University-Academics/MPPT-CHARGE-CONTROLLER/README.md

# MPPT-CHARGE-CONTROLLER
EN2110 : Project
