University-Academics/MPPT-CHARGE-CONTROLLER/Submission Files/MPPT.pptx

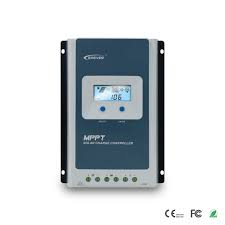
[picture p7: figure]

MPPT
CHARGE
CONTROLLER

GROUP-13

## Slide 2

Role of a Charge Controller?

- Ensure Safety of Battery
  - Over Charging
  - Deep Discharging
  - Proper charging parameters
- Ensure safety of Solar Panels
  - Dusk/ night : Back flow protection
- Effective power management

Direct Connection
PWM Charge Controller
MPPT

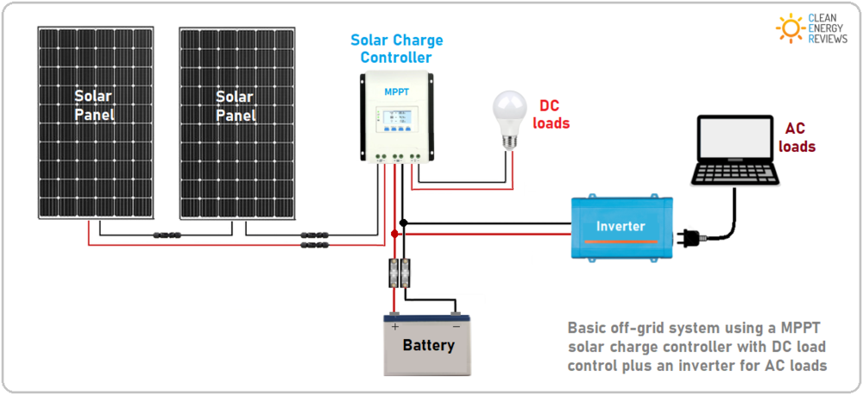
[picture p8: figure]

## WHY MPPT?

But due to environmental fluctuations

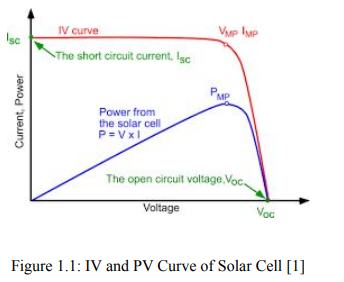
[picture p9: figure]

MPPT Algorithm must constantly tracking the Maximum power point. It increases the efficiency by 30%

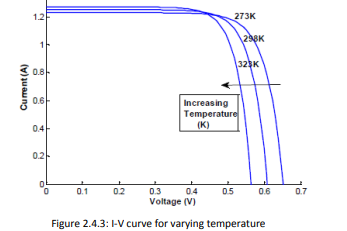
[picture p10: figure]
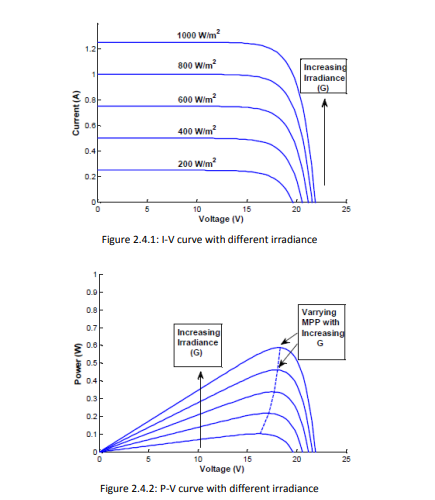
[picture p11: figure]

## IMPLEMENTATION OF MPPT

- Several methods exists.
  - Perturb and Observe method
  - Incremental conductance method
  - Constant voltage method

Perturb and Observe method(Our Project uses this method)
- Easy to implement
- constantly checking the voltage (or current in some systems) and continuing to increase the voltage as long as the power continues to increase
- Disadvantage is the system oscillates around the power point

Incremental Conductance Method
- Implementation is complex
- Accuracy is higher than P & O method

## MPPT ALGORITHM(P & O Method)

- •Simplest method of MPPT
- •Hill climbing method on two-point power comparison method
Concept

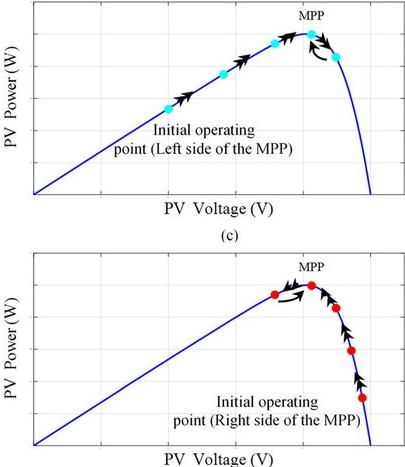
[picture p12: figure]
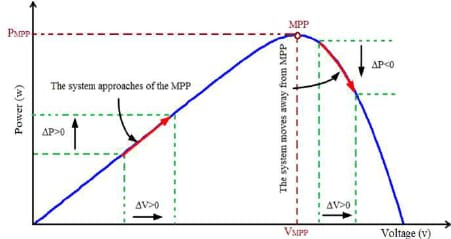
[picture p13: figure]

## Flow Chart

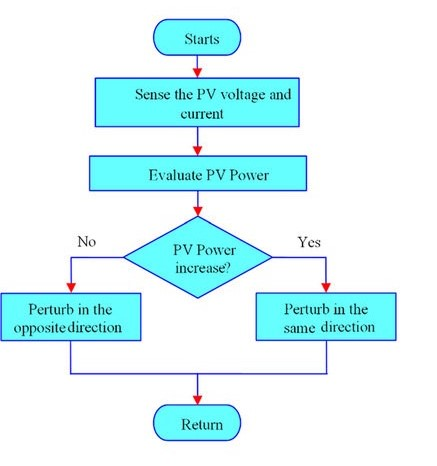
[picture p14: figure]
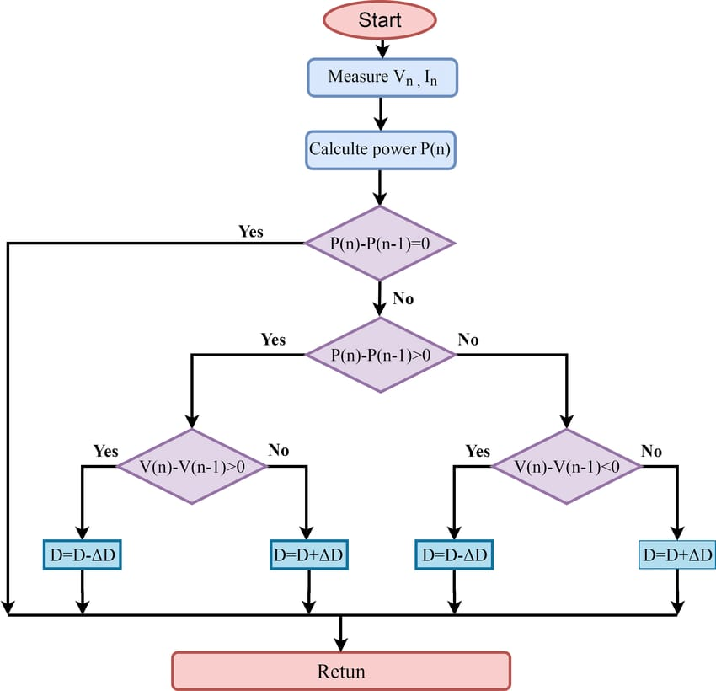
[picture p15: figure]

## Functional Block Diagram

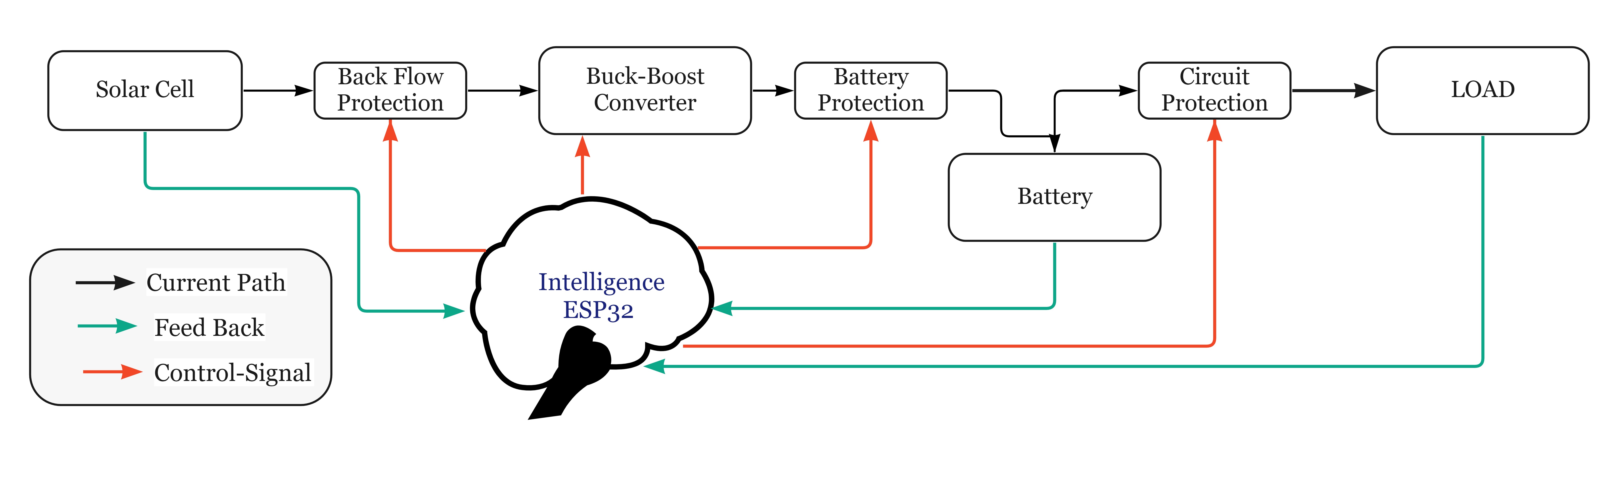
[picture p16: figure]

## Specifications

- 40V, 30A Input(Solar, Wind Turbines, PSU)
  - 12V OUTPUT/ BATTERY - 420W @35A
  - 24V OUTPUT/ BATTERY - 840W @35A
- Wi-Fi & Bluetooth
- 98% Peak conversion efficiency
- Battery & Input Disconnect Recovery Protocol
- Settable PWM Switching Frequency(1.2kHz - 312kHz)

## What to Expect ??

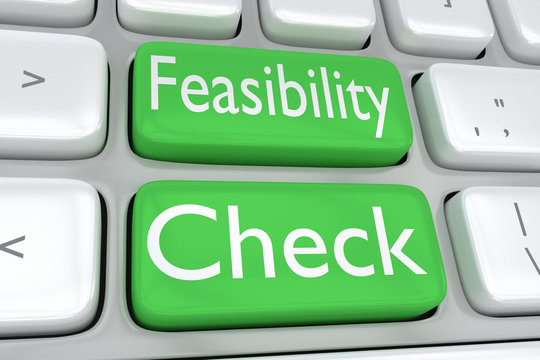
[picture p17: figure]

- 30V,10A Input(Solar)
  - 12V OUTPUT/BATTERY - 60W@5A
- 90 % Peak-Conversion Efficiency
- Settable PWM Frequency
- Two 12V Smart lighting system as Load (20W)

## Buck Converter

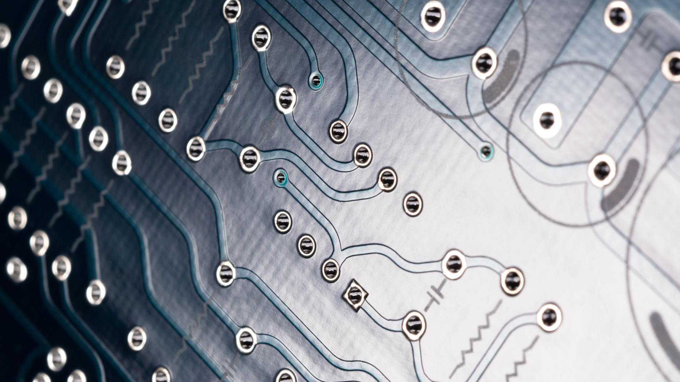
[picture p18: figure]
An electronic circuit board in blue colour

## Asynchronous Buck Converter

- Typical Efficiency: 75-87%
- Notable power loss across the diode’s forward voltage drop (V_f =0.6V−1.2V).
- Easy and straight forward implementation

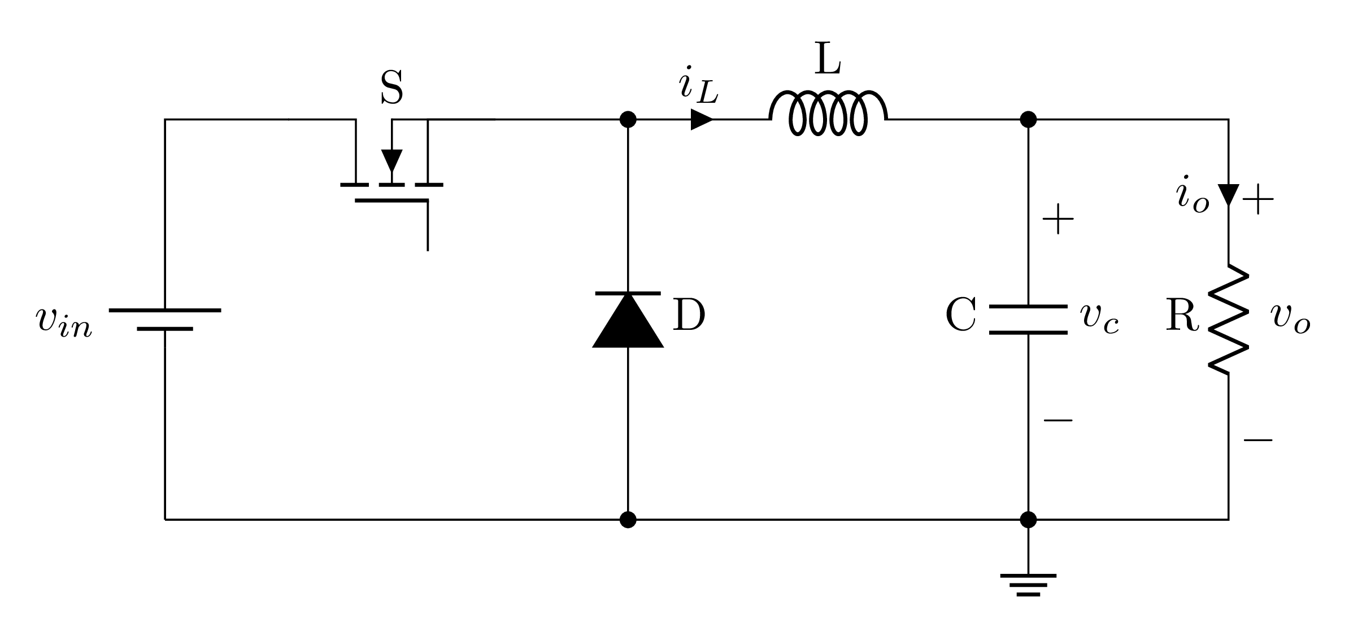
[picture p19: figure]

Solution : Synchronous Buck Converter

## Synchronous Buck Converter

- Typical Efficiency: 88-98%
- Minuscule losses formed across MOSFET’s on-resistance
- Proper implementation of switching required.

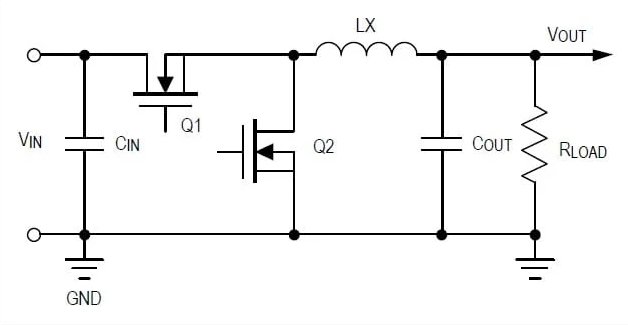
[picture p20: figure]

Solution : Use Half-Bridge MOSFET driver

## Half-Bridge MOSFET driver (IR2104)

- Fully operational to +600V.
- Gate drive supply range from 10 to 20V.
- High side output in phase with input.
- Shut down input turns off both channels

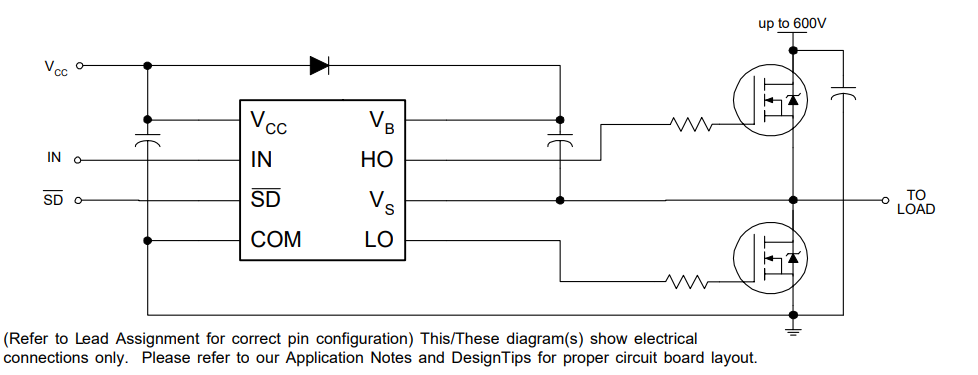
[picture p21: figure]
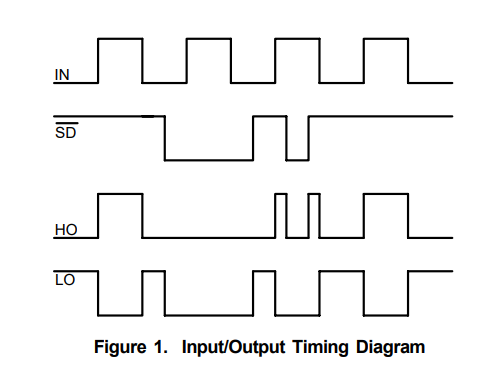
[picture p22: figure]
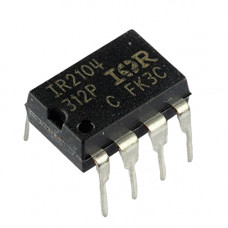
[picture p23: figure]

## MOSFET Selection

- Should be capable of high frequency switching.
- Should be capable of high drain current. I_D ≥35A.
- Should have low on-resistance.
- Low conduction loss and switching loss.

We have chosen IRFZ48N MOSFET.

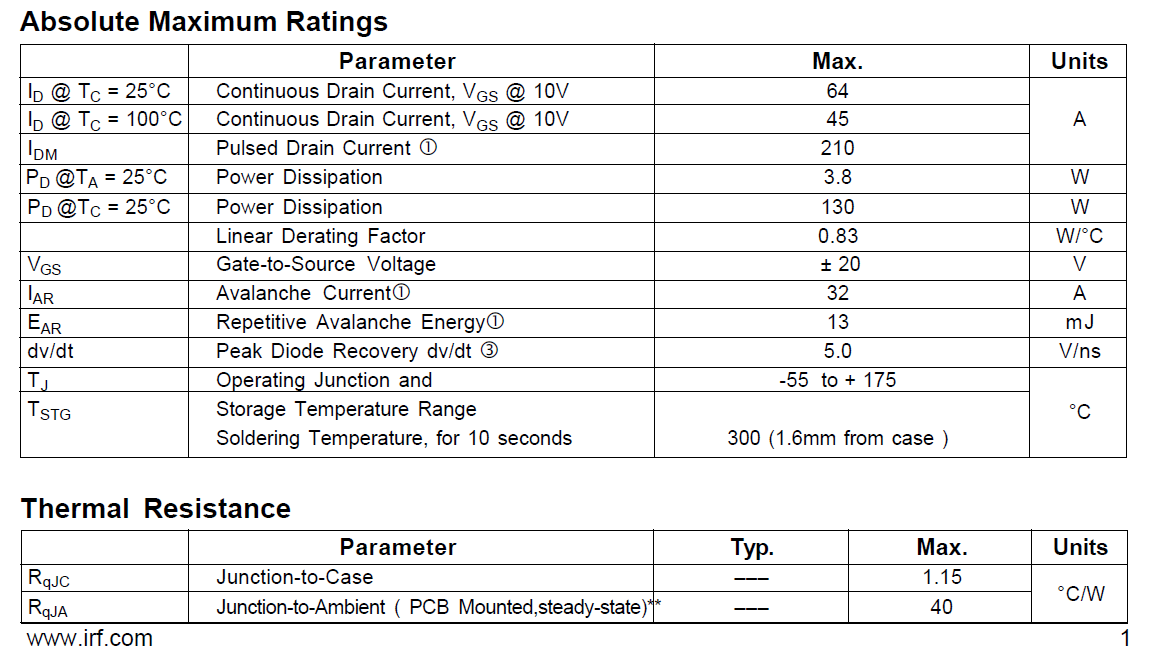
[picture p24: figure]

## Inductor Selection

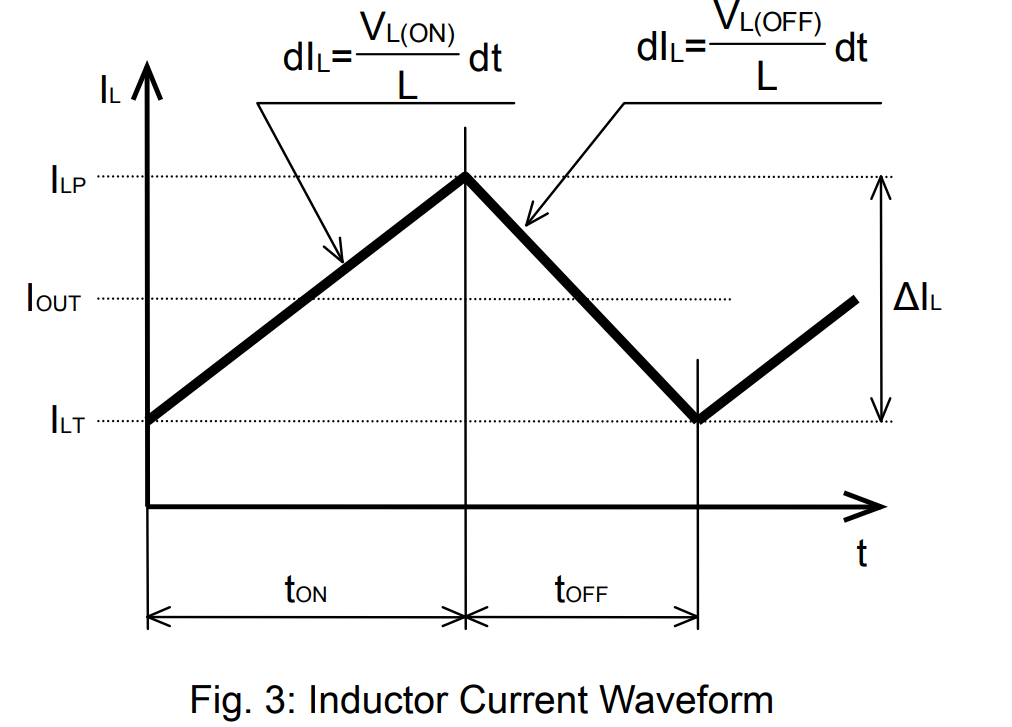
[picture p25: figure]

- We are design 840W solar panel.
- Input voltage V_(in) =40V.
- Output voltage V_(out) =24V.
- ∴I_(out) =(840W)/(24V)=35A.
- Ripple current ΔI_L is taken as 20% of I_(out) .
- PWM frequency 30kHz.
L=(V_(out) ×(V_(in) −V_(out) ))/(ΔI_L ×f_s ×V_(in))
L≈48μH

We plan to wind a toroidal inductor with L=48μH.

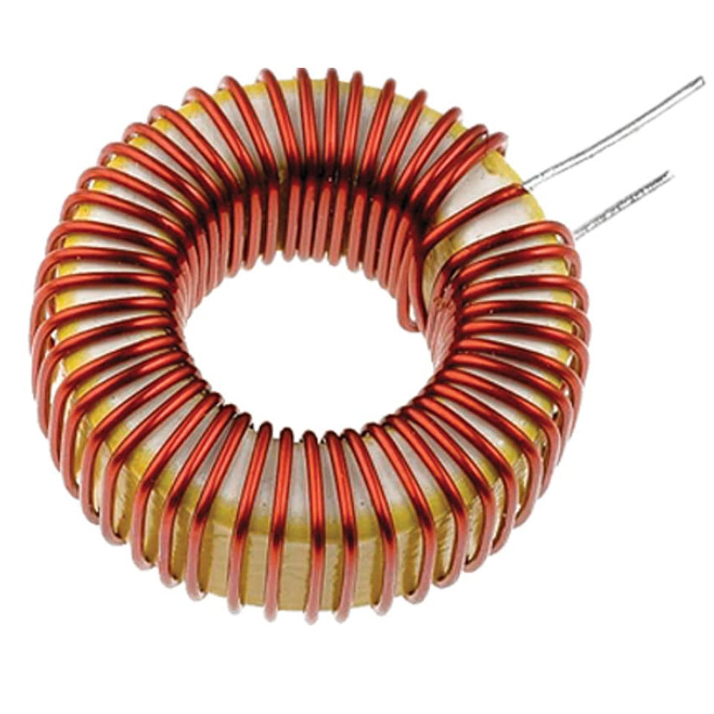
[picture p26: figure]
Custom Inductors & Chokes : The Talema Group

Reference : Texas Instruments (https://www.ti.com/lit/an/slva477b/slva477b.pdf?ts=1652065112004)

## Output Capacitor Selection

- Output capacitance is required to minimize the voltage overshoot and ripple at the output.
- Should have low equivalent-series resistance (ESR).
- Output ripple voltage is taken as 60mV.
C_(out) =(ΔI_L)/(8f_s ΔV_(out))
≈470μF

Required 470μF output capacitor.

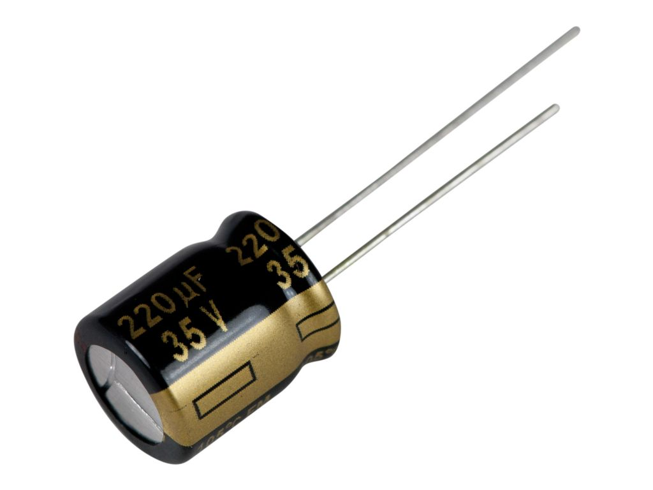
[picture p27: figure]
Radial electrolytic capacitor Low ESR CE 220u/35VIT PAN-FM 10x12,5 RM5 | GM electronic COM

Reference : Texas Instruments (https://www.ti.com/lit/an/slva477b/slva477b.pdf?ts=1652065112004)

## Slide 17

Voltage Measurement

- Two voltage divider circuits are used to measure solar panel and battery voltage.

- Two analog pins of the esp32 are used to read voltages.

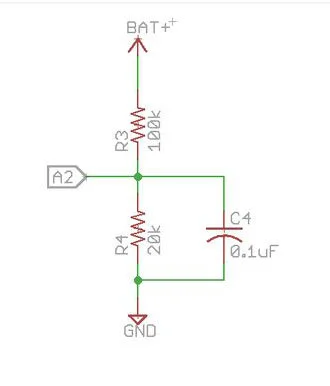
[picture p28: figure]

For the battery voltage measuring

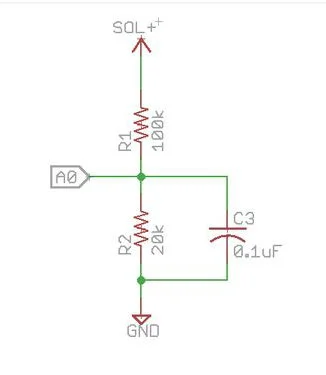
[picture p29: figure]

For the solar panel voltage measuring

Vout = R2/(R1+R2) x Vin
Vin = (R1+R2)/R2 x Vout
Solar Panel = ADC x 0.0049 x (R1+R2)/R2

Count

Voltage

## Slide 18

Current Measurement

- ASC712 (5A) current sensor is used to measure the current.

ASC712 current sensor :

- Sensitivity is 185mV/A

- The power supply is 5V

- The sensor can measure positive and negative currents (-5A to +5A)

- Offset is 2.5V

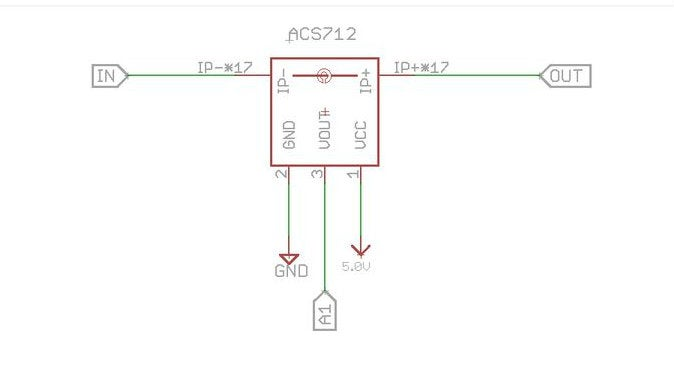
[picture p30: figure]

Value = (5/1024) x analog read value

Current in amp = (value-2.5)/0.185

## Slide 19

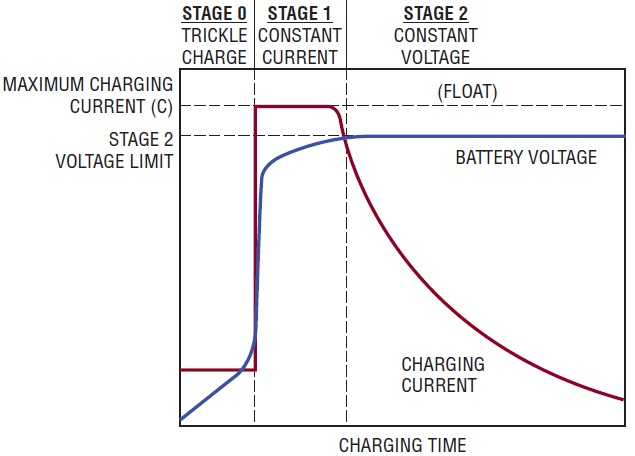
[picture p31: figure]

Battery Charging Stages

Click to add text

## DRIVING LOAD...!

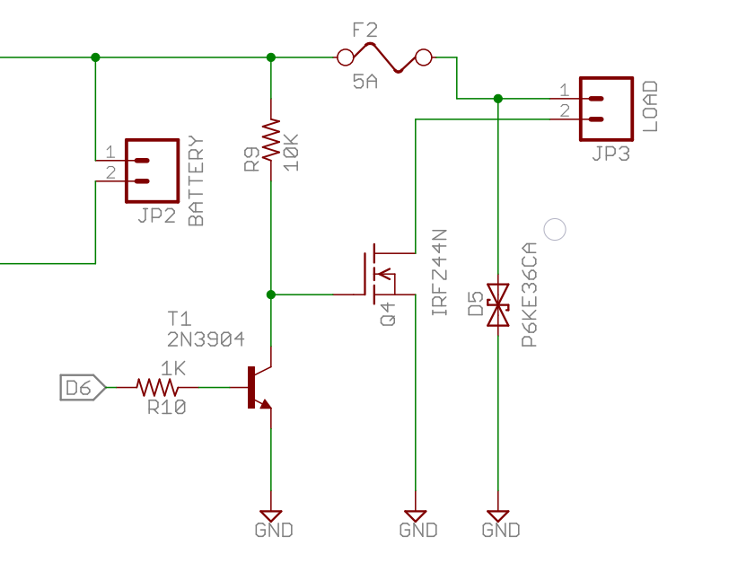
[picture p32: figure]

No Requirements for Faster Switching
Protection : Fuse and TVS Diode

## Power Supplies

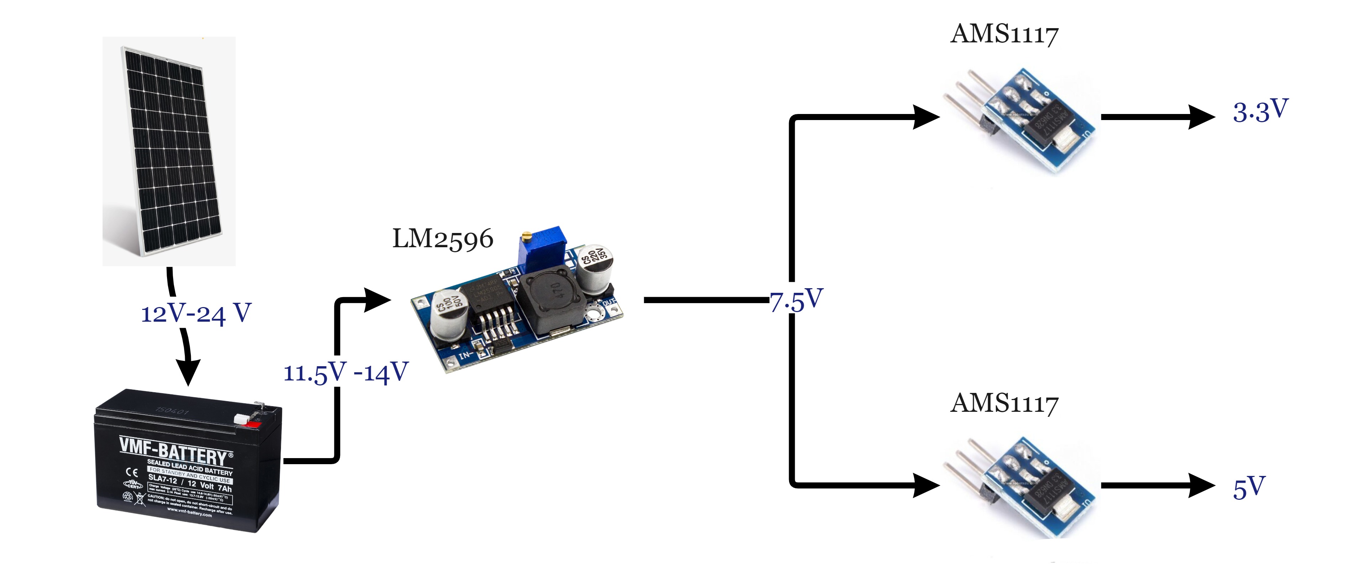
[picture p33: figure]
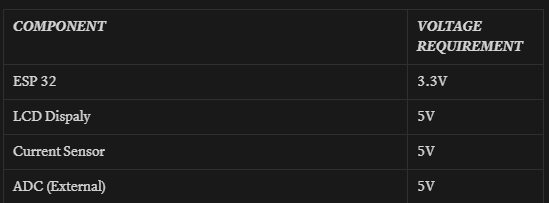
[picture p34: figure]

LINEAR REGULATOR
V_out = V_ref (1+R1/R2)
V_ref = 1.25V

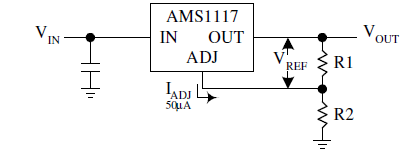
[picture p35: figure]

Dc-Dc Buck Converter

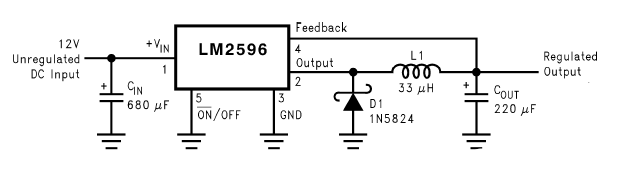
[picture p36: figure]

## Slide 22

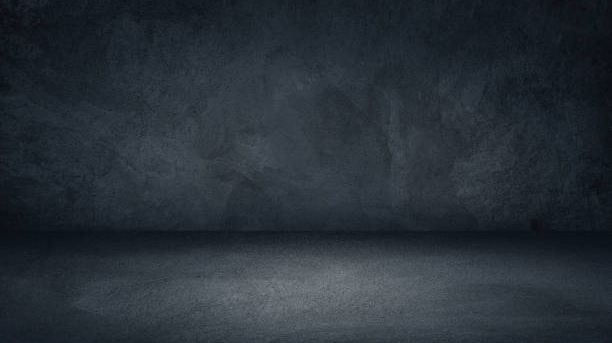
[picture p37: figure]
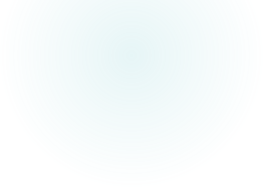
[picture p38: figure]

SAFE OPERATION....!

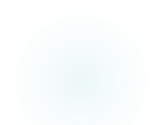
[picture p39: figure]

## Slide 23

BODY DIODE CURRENT LEAKAGE

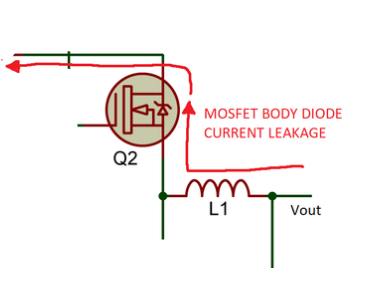
[picture p40: figure]

NEED FOR A BETTER DESIGN ?

SCHOTTKY DIODE
MOSFET & MOSFET DRIVER
ISOLATED POWER SUPPLY

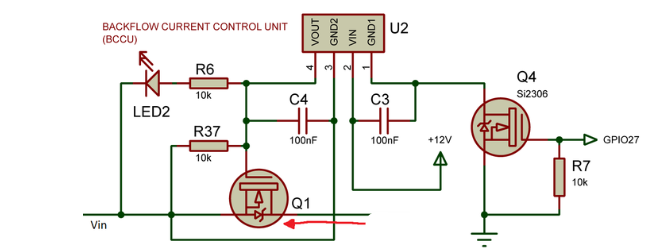
[picture p41: figure]

REVERSE BLOCKING MOSFET CONFIGURATION

## IMPLEMENTATION LEVEL

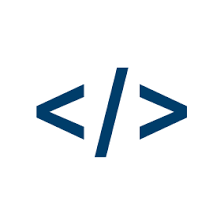
[picture p42: figure]

- LIGHTENING OVER VOLTAGE SURGE : TVS DIODE
- AUTO LOAD DISCONNECTION : DEEP DISCHRAGING
- ENSURING PROPER CHARGING PARAMETERS
  - SWITCHING TO CONSTANT VOLTAGE STAGE
  - BATTERY TEMPERATURE
- PROTECTION AGAINST FAILURES

## PLACES WHERE WE EXPECT PROBLMS

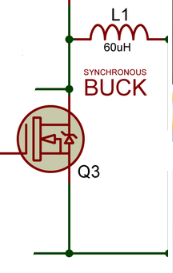
[picture p43: figure]

- DUTY CYCLE OF PWN SIGNAL : LOWER SIDE MOSFET
- NON-LINEAR RESPONSE OF ADC (ESP32)
External Precision ADC : AD1015 (12-bit resolution with 3800sps speed)
HIGHER -> Finer Voltage and Current Steps , Power Handling
- PWM FREQUENCY SELECTION :
LOWER -> Switching losses are low

ESP32 : 16 PWM PINS
16 bit resolution : 1.22kHz
12 bit resolution : 19.5kHz
11 bit resolution : 39.06kHz
10 bit resolution : 78.12kHz

## Trying to do better...!

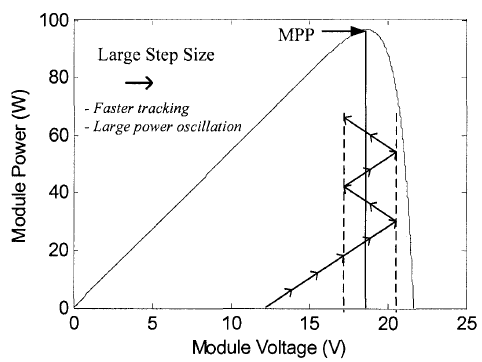
[picture p44: figure]

LARGER STEP :
OSCILLATION

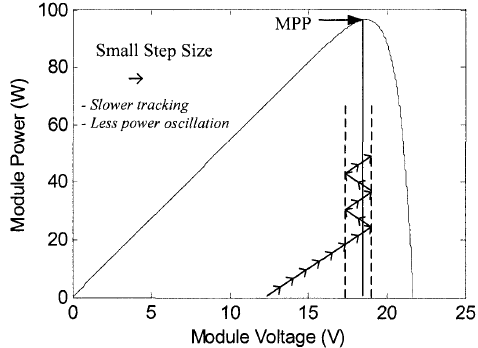
[picture p45: figure]

SMALLER STEP :
FASTER CHANGING CONDITIONS

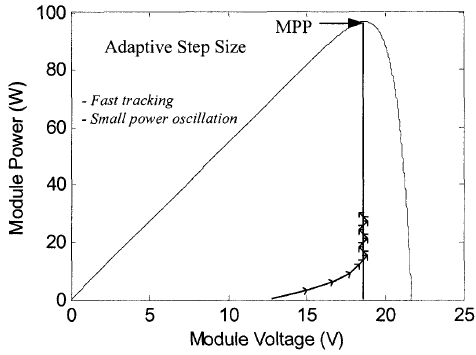
[picture p46: figure]

ADAPTIVE STEP SIZE

## Slide 27

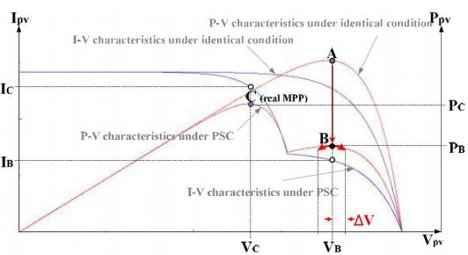
[picture p47: figure]

PARTIAL SHADING

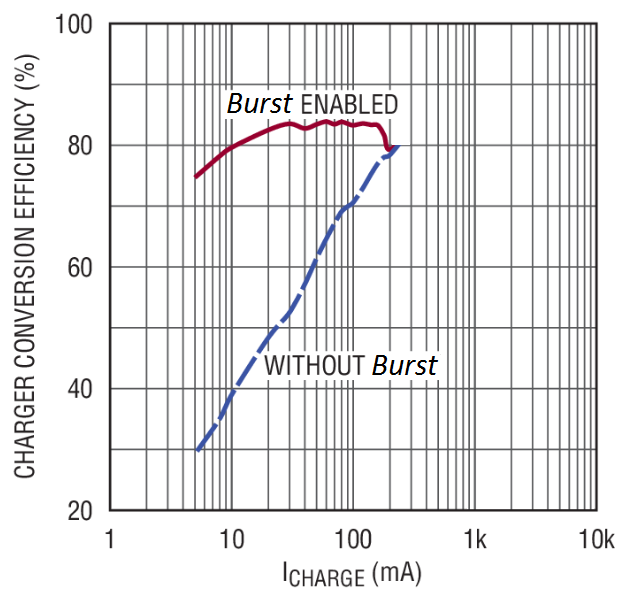
[picture p48: figure]

BURST CHARGING

SOLUTION : 5-STATE MODEL

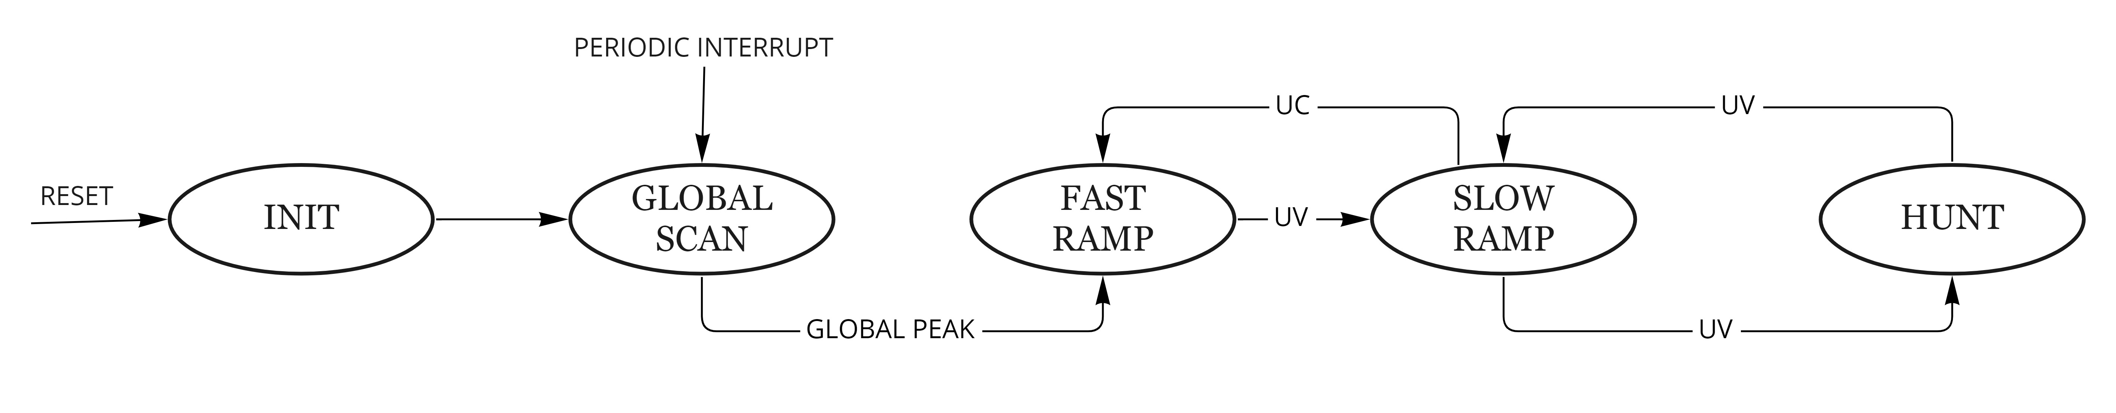
[picture p49: figure]

## EXCITED TO EXPERIMENT...!
