University-Academics/MPPT-CHARGE-CONTROLLER/References/Circuit References/second.png

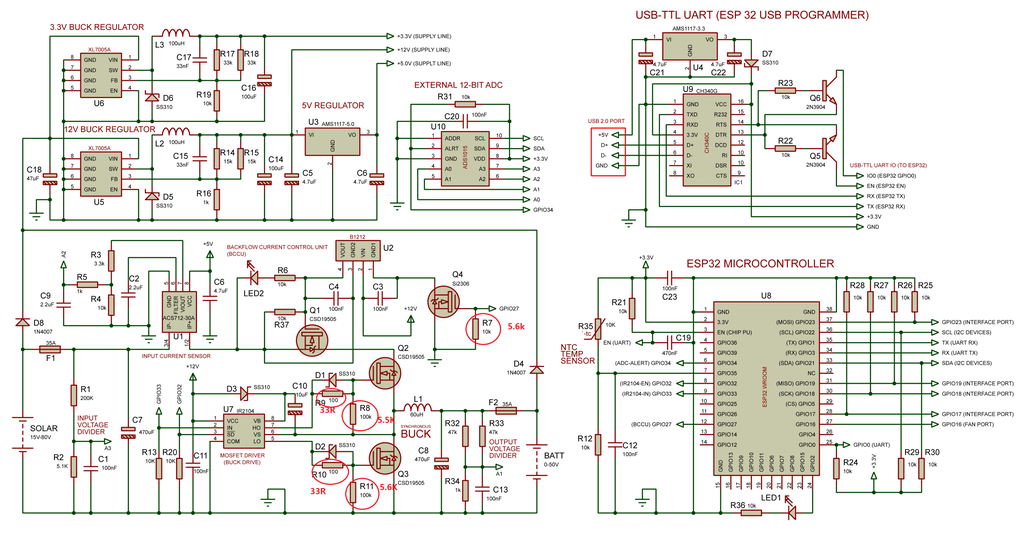
References/Circuit References/second.png
