University-Academics/MPPT-CHARGE-CONTROLLER/MPPT_PCB/schematic.pdf

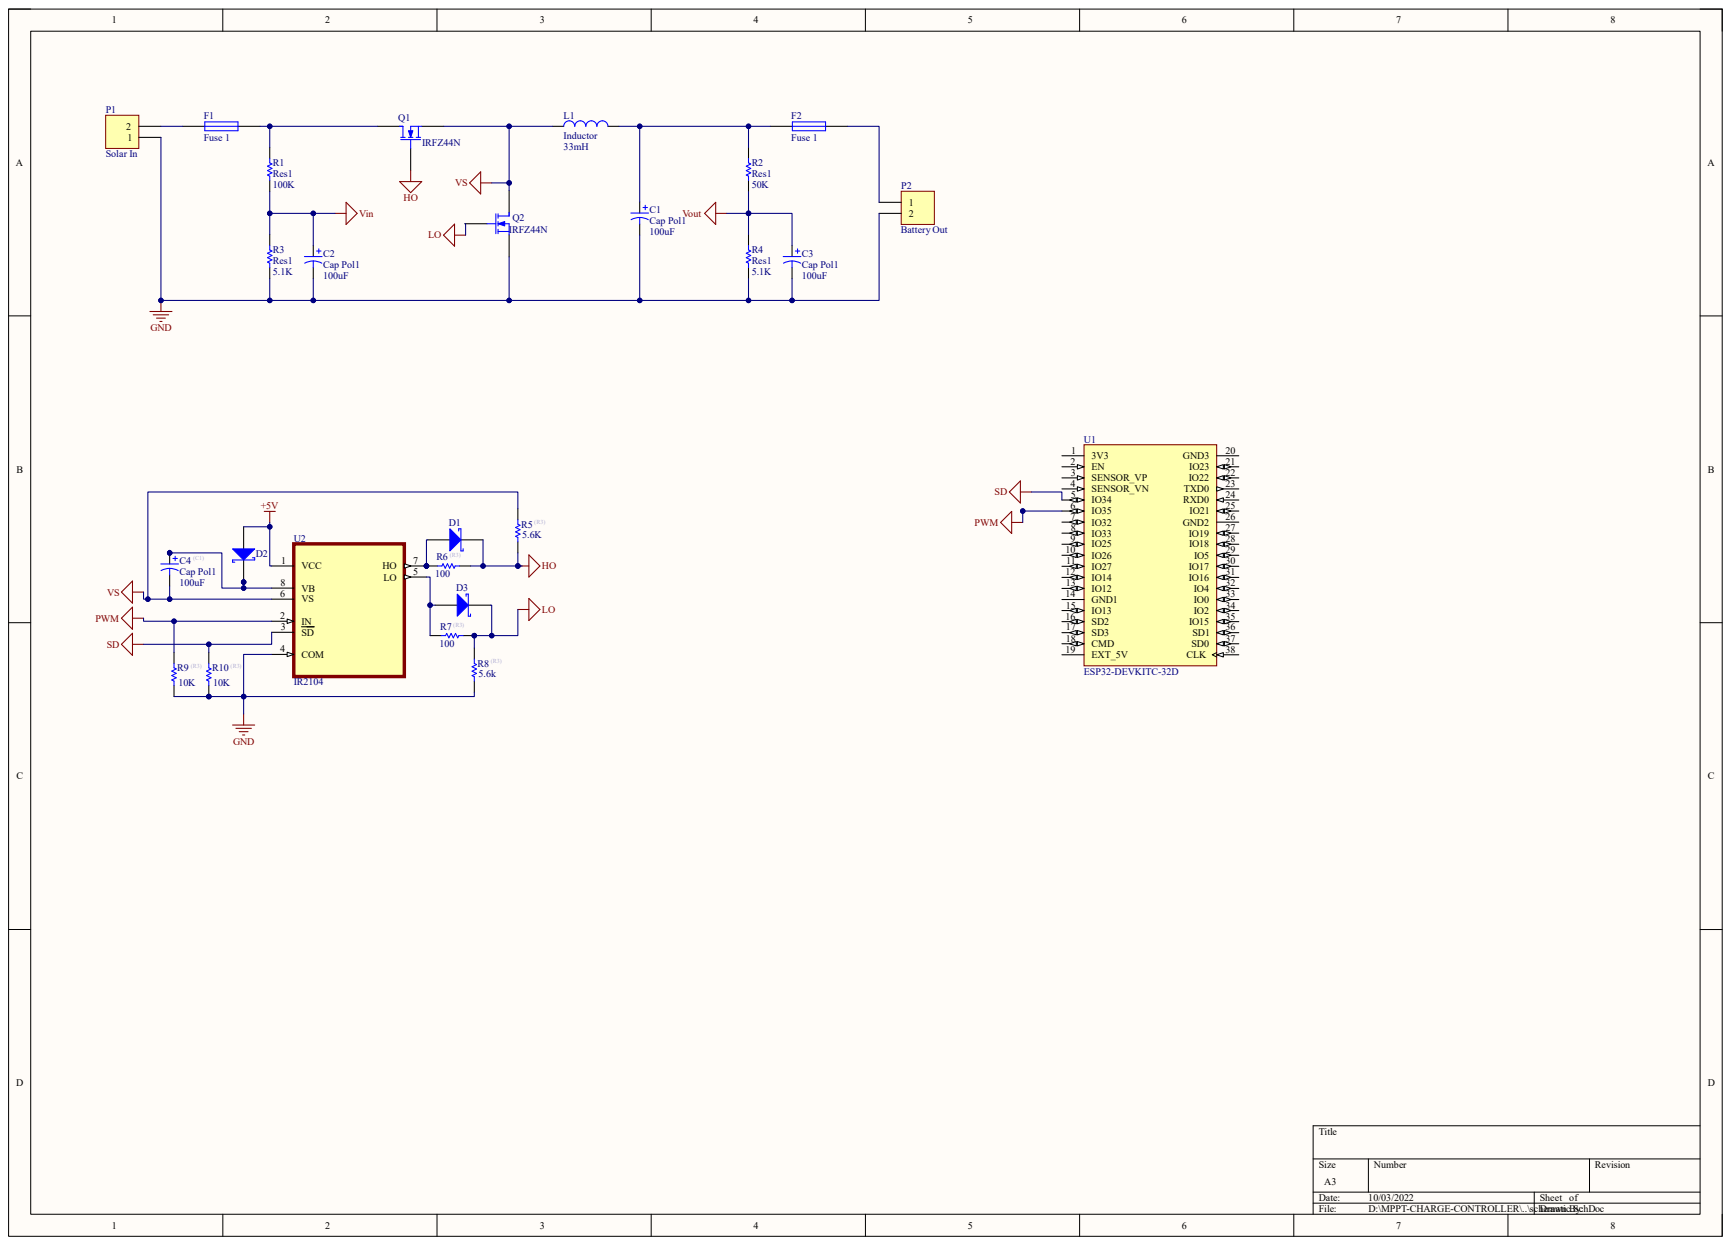
[picture p51: page 1]
