University-Academics/MPPT-CHARGE-CONTROLLER/(list of files, drawings)

Other design files:
MPPT_PCB/MPPT_PCB.PrjPcb
MPPT_PCB/schematic.SchDoc
Stimulation/Buck Converter/buck.pdsprj
