University-Academics/MPPT-CHARGE-CONTROLLER/Wifi/sketch_oct5a/sketch_oct5a.ino

#include <WiFi.h>
#include <PubSubClient.h>

const char* ssid = "DT4G";
const char* password = "iuytrewq";
const char* mqtt_server = "13.76.34.183";

WiFiClient espClient;
PubSubClient client(espClient);

void initWiFi() {
  WiFi.mode(WIFI_STA);
  WiFi.begin(ssid, password);
  Serial.print("Connecting to WiFi ..");
  while (WiFi.status() != WL_CONNECTED) {
    Serial.print('.');
    delay(1000);
  }
  Serial.println(WiFi.localIP());
}

void reconnect() {
  // Loop until we're reconnected
  while (!client.connected()) {
    Serial.print("Attempting MQTT connection...");
    // Attempt to connect
    if (client.connect("ESP8266Client", "mppt-solar", "sem4electronics@entc19")) {
      Serial.println("connected");
      // Subscribe
      //client.subscribe("esp32/output");
    } else {
      Serial.print("failed, rc=");
      Serial.print(client.state());
      Serial.println(" try again in 5 seconds");
      // Wait 5 seconds before retrying
      delay(5000);
    }
  }
}

void setup() {
  // put your setup code here, to run once:
  Serial.begin(115200);
  initWiFi();
  Serial.print("RRSI: ");
  Serial.println(WiFi.RSSI());
  client.setServer(mqtt_server, 1883);
}

void loop() {
  // put your main code here, to run repeatedly:
  if (!client.connected()) {
    reconnect();
  }
  client.loop();
  client.publish("testtopic", "tempString");
  delay(5000);
}
