University-Academics/MPPT-CHARGE-CONTROLLER/(commit log)

2022-05-09 buck converter simulation.
2022-05-09 buck converter
    [buck.pdsprj]
2022-05-09 buck converter tested.
    [buck.pdsprj]
2022-10-06 FINISHED INTIAL SKETCH IN CODING
    [buck.pdsprj]
2022-10-07 Created PCB and add some datasheets
    [MPPT_PCB.PrjPcb, PCB_Project.PrjPcb, buck.pdsprj, schematic.SchDoc]
2022-10-08 added the iot part and corrected the overload error.
    [iot_config.ino, lcd_menu.ino, main_controller.ino, read_sensor.ino]
2022-10-09 ADDED EXPLANATION ON CAPACITOR AND INDUCTOR SELECTION
2022-10-10 CODE 0.4 : DEMONSTRATION STAGE
